Szymon423/Weather-station/Schematic_Stacja Pogodowa_2022-10-20.pdf

IO0 27 IO35 28 IO36 29 IO37 30 IO38 31 IO39 32 IO40 33 IO41 34 IO42 35 RXD0 36 TXD0 37 IO2 38 IO1 39 GND 40

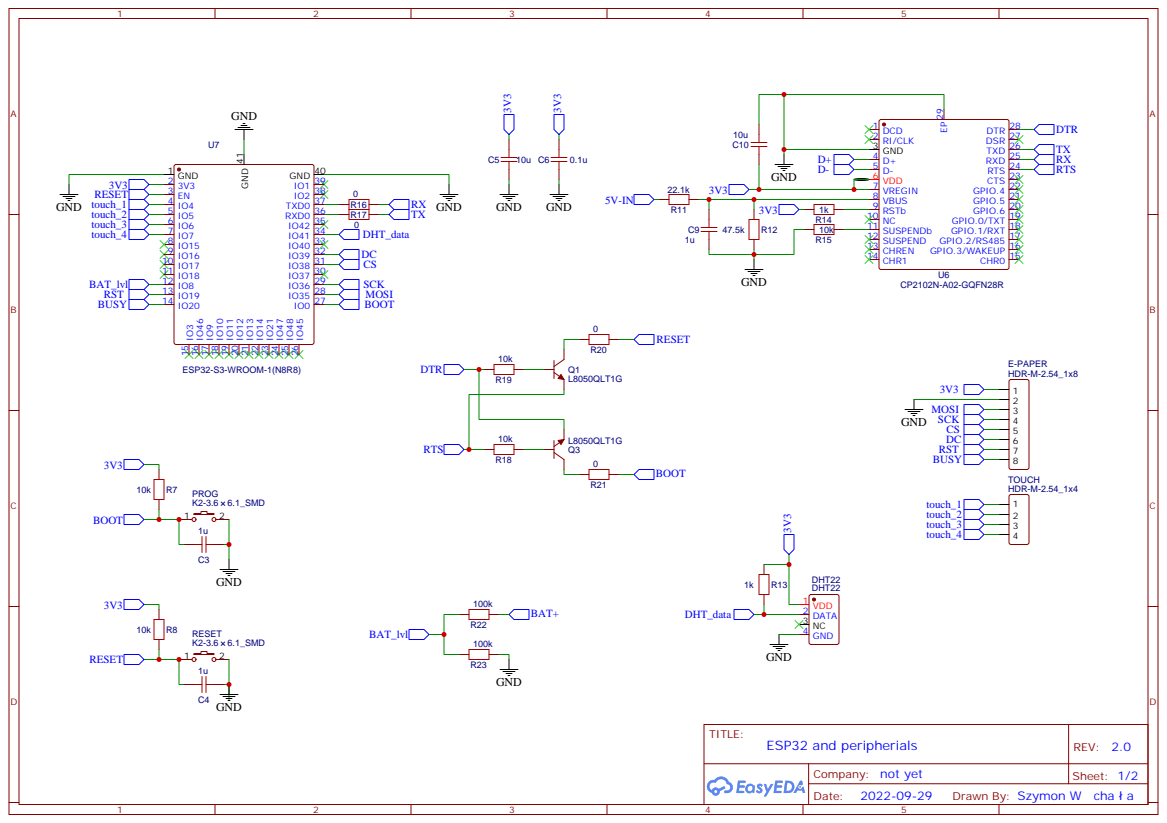
[picture p3: page 1]

Drawn By: Szymon W cha a

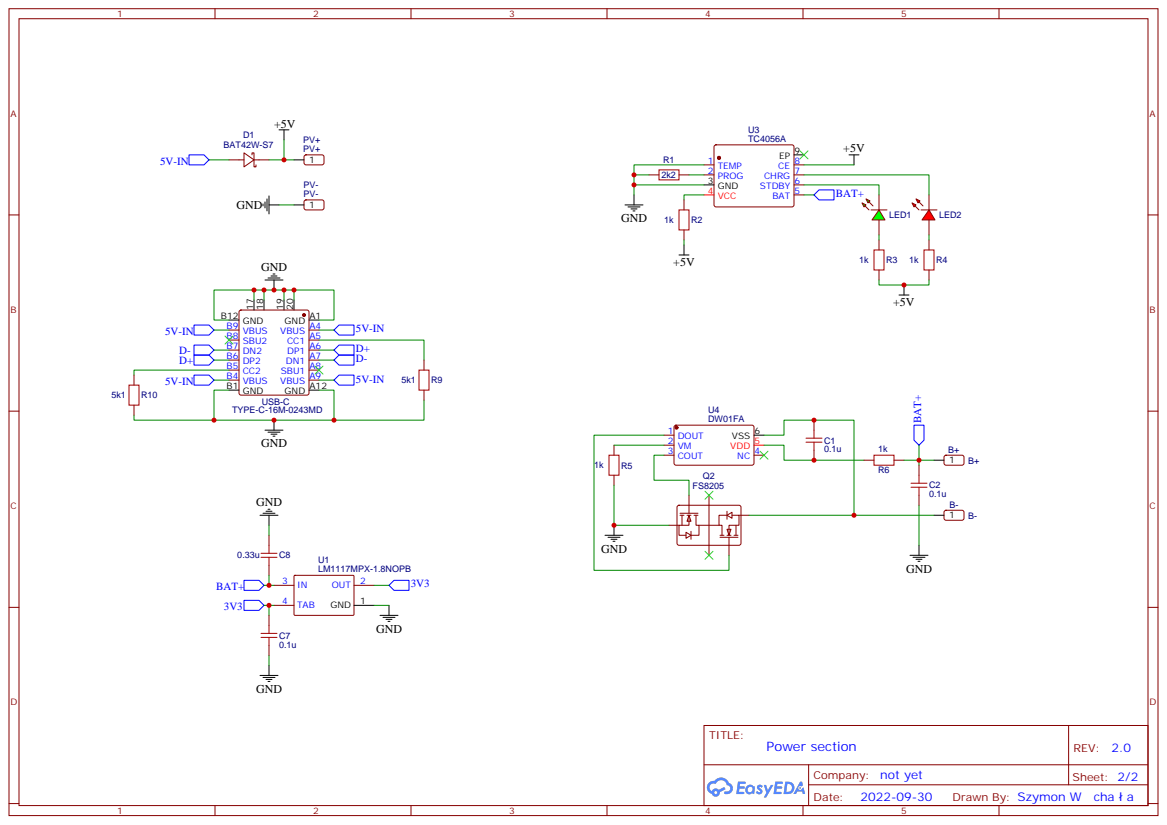
[picture p4: page 2]

Drawn By: Szymon W cha a
