Szymon423/Weather-station/ESP32-code/weatherAPI.h

#pragma once

#include <Arduino.h>
#include <String.h>


class WeatherAPI {
  // class responsible for recieving weather data from API

  public:
    String icon;
    String windSpeed;
    String temp;
    String tempMax;
    String tempMin;
    String tempFeelsLike;
    String pressure;
    String humidity;

  private:
    String JSON;
    String APIKey;
    String coordinatesLon;
    String coordinatesLat;
    String requestString;

  private: 
    void getData();
    void processData();
    void generateRequestString();
    String getValueOf(String);

  public:
    void update();
    WeatherAPI();
    ~WeatherAPI();

};
