Szymon423/Weather-station/(commit log)

2022-10-21 PCB ordered
2022-11-19 power consumption measurements
